mole99/sg13g2_leo_ip__ota5t/docs/sg13g2_leo_ip__ota5t_pex.md

# CACE Summary for sg13g2_leo_ip__ota5t

**netlist source**: pex

| Parameter | Tool | Result | Min Limit  |  Min Value | Typ Target |  Typ Value | Max Limit  |  Max Value |  Status  |
| :--- | :--- | :--- | ---: | ---: | ---: | ---: | ---: | ---: | :---: |
| DC gain | ngspice | a0 | 10 V/V | 19.362 V/V | any | 30.532 V/V | any | 44.194 V/V | Pass ✅ |
| Unity Gain Frequency | ngspice | ugf | 1e6 Hz | 15563000.000 Hz | any | 21388300.000 Hz | any | 27341000.000 Hz | Pass ✅ |
| Phase Margin | ngspice | pm | 60 ° | 85.090 ° | any | 86.393 ° | any | 88.294 ° | Pass ✅ |
| DC gain MC | ngspice | a0 | 10 V/V | 13.176 V/V | any | 21.056 V/V | any | 28.911 V/V | Pass ✅ |
| Area | magic_area | area | | | | | 600 µm² | 76.850 µm² | Pass ✅ |
| Width | magic_area | width | | | | | any | 9.685 µm | Pass ✅ |
| Height | magic_area | height | | | | | any | 7.935 µm | Pass ✅ |
| Magic DRC | magic_drc | drc_errors | | | | | 0 | 0 | Pass ✅ |
| Netgen LVS | netgen_lvs | lvs_errors | | | | | 0 | 0 | Pass ✅ |
| KLayout DRC maximal  | klayout_drc | drc_errors | | | | | 0 | 0 | Pass ✅ |
| Antenna Checks | magic_antenna_check  | antenna_violations | | | | | 0 | 0 | Pass ✅ |

## Plots

## gain_vs_temp

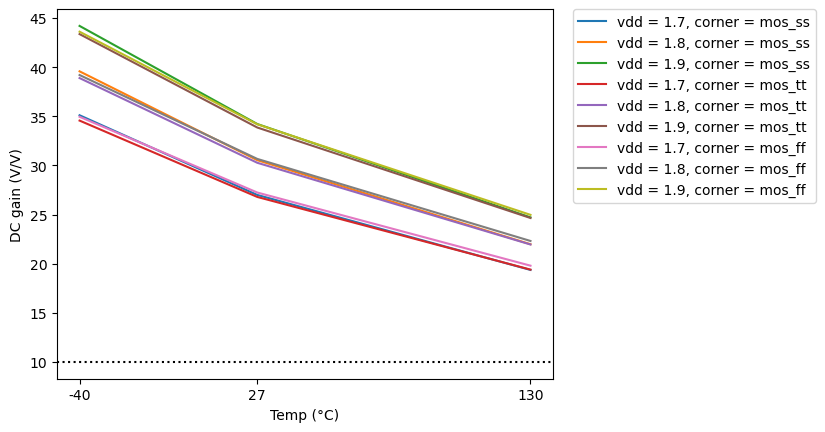
[picture p10: docs/sg13g2_leo_ip__ota5t/pex/gain_vs_temp.png]
gain_vs_temp


## ugf_vs_corner

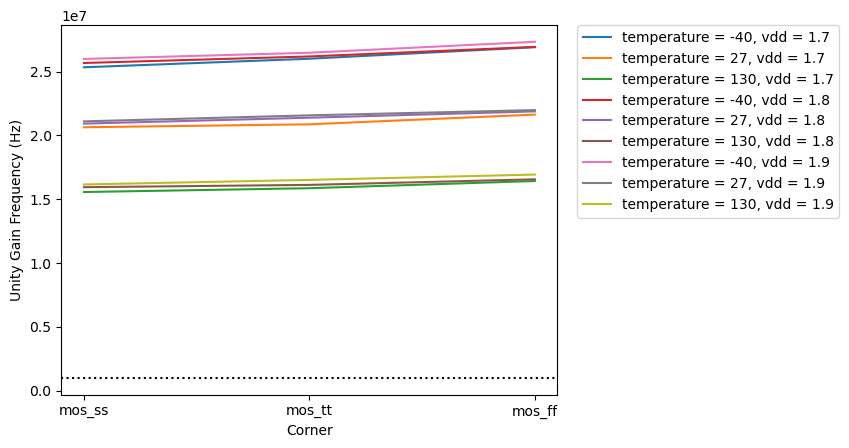
[picture p11: docs/sg13g2_leo_ip__ota5t/pex/ugf_vs_corner.png]
ugf_vs_corner


## pm_vs_vdd

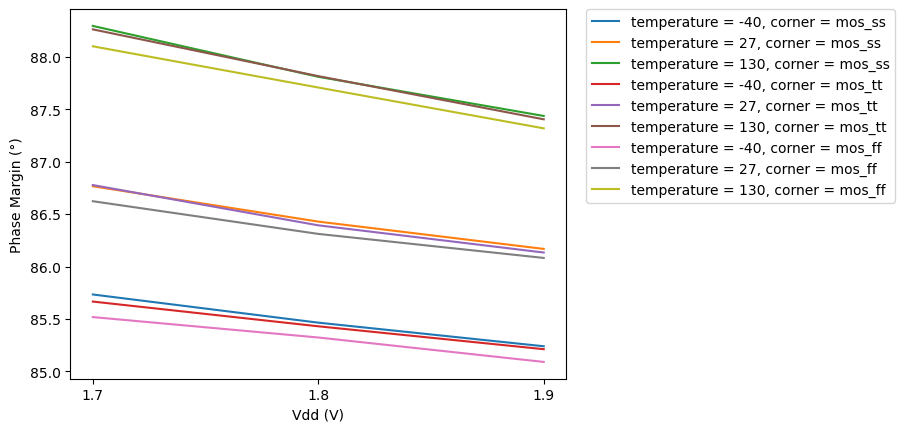
[picture p12: docs/sg13g2_leo_ip__ota5t/pex/pm_vs_vdd.png]
pm_vs_vdd


## gain_mc

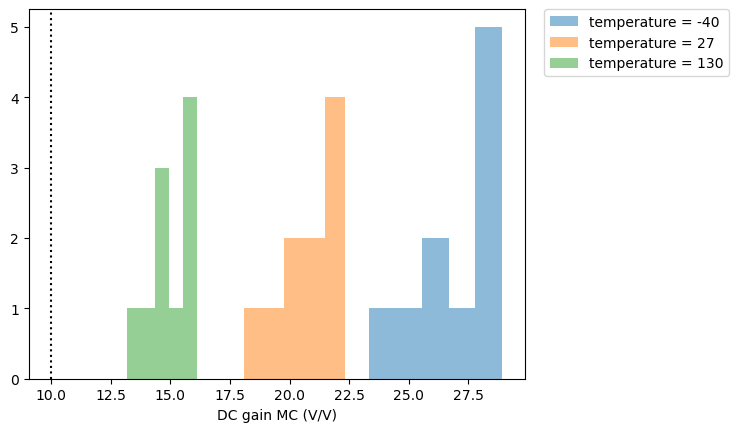
[picture p13: docs/sg13g2_leo_ip__ota5t/pex/gain_mc.png]
gain_mc


## transient

transient
