mole99/sg13g2_leo_ip__ota5t/cace/sg13g2_leo_ip__ota5t.yaml

#--------------------------------------------------------------
# CACE circuit characterization file
#--------------------------------------------------------------

name:           sg13g2_leo_ip__ota5t
description:    A simple 5-transistor OTA
PDK:            ihp-sg13g2

cace_format:    5.2

authorship:
  designer:         Leo Moser
  creation_date:    June 27, 2025
  license:          Apache 2.0

paths:
  root:             ..
  schematic:        xschem
  layout:           gds
  netlist:          netlist
  documentation:    docs

pins:
  VDD:
    description: Positive analog power supply
    type: power
    direction: inout
    Vmin: 1.4
    Vmax: 1.6
  VSS:
    description: Analog ground
    type: ground
    direction: inout
  Ib:
    description: Bias current input
    type: signal
    direction: input
  Vp:
    description: Voltage positive input
    type: signal
    direction: input
  Vn:
    description: Voltage negative input
    type: signal
    direction: input
  Vout:
    description: Voltage output
    type: signal
    direction: output

default_conditions:
  vdd:
    description: Analog power supply voltage
    display: Vdd
    unit: V
    typical: 1.5
  vcm:
    description: Input common mode voltage
    display: Vcm
    unit: V
    typical: 0.75
  ib:
    description: Bias current
    display: Ib
    unit: uA
    typical: 10
  cl:
    description: Output load capacitance
    display: CLoad
    unit: pF
    maximum: 1
  corner:
    description: Process corner
    display: Corner
    typical: mos_tt
  temperature:
    description: Ambient temperature
    display: Temp
    unit: °C
    typical: 27

parameters:
  dc_params:
    display: DC Params
    spec:
      a0:
        display: DC gain
        description: The DC gain of the OTA
        unit: V/V
        minimum:
          value: 10
        typical:
          value: any
        maximum:
          value: any
      ugf:
        display: Unity Gain Frequency
        description: The unity gain frequency of the OTA
        unit: Hz
        minimum:
          value: 1e6
        typical:
          value: any
        maximum:
          value: any
      pm:
        display: Phase Margin
        description: The phase margin of the OTA
        unit: °
        minimum:
          value: 60
        typical:
          value: any
        maximum:
          value: any
    tool:
      ngspice:
        template: ac.sch
        format: ascii
        suffix: .data
        variables: [a0, ugf, pm]
    plot:
      gain_vs_temp:
        type: xyplot
        xaxis: temperature
        yaxis: a0
        limits: auto
      ugf_vs_corner:
        type: xyplot
        xaxis: corner
        yaxis: ugf
        limits: true
      pm_vs_vdd:
        type: xyplot
        xaxis: vdd
        yaxis: pm
        limits: false
    conditions:
      corner:
        minimum: mos_ss
        typical: mos_tt
        maximum: mos_ff
      vdd:
        minimum: 1.7
        typical: 1.8
        maximum: 1.9
      temperature:
        minimum: -40
        typical: 27
        maximum: 130

  gain_mc:
    description: DC gain Monte Carlo
    display: DC gain MC
    unit: V/V
    spec:
      a0:
        minimum:
          value: 10
        typical:
          value: any
        maximum:
          value: any
    tool:
      ngspice:
        template: ac.sch
        # Merge runs with the same conditions
        # but different iterations
        # This is used for plotting
        collate: iterations
        format: ascii
        suffix: .data
        variables: [a0, null, null]
    plot:
      gain_mc:
        type: histogram
        xaxis: a0
        limits: auto
    conditions:
      iterations:
        description: Iterations to run
        display: Iterations
        minimum: 1
        maximum: 10
        step: linear
        stepsize: 1
      corner:
        typical: mos_tt_stat
      temperature:
        minimum: -40
        typical: 27
        maximum: 130

  transient_response:
    description: Large signal transient response
    display: Large signal transient response
    status: skip
    unit: mV
    tool:
      ngspice:
        template: transient.sch
        format: ascii
        suffix: .data
        variables: [time, Vout, Vinp]
        jobs: 4
    plot:
      transient:
        suffix: .svg
        xaxis: time
        yaxis: [Vout, Vinp]
    variables:
      time:
        display: Time
        unit: ms
      Vinp:
        display: Vinp
        unit: V
      Vout:
        display: Vout
        unit: V
    conditions:
      Tmax:
        display: Simulation time
        unit: ns
        typical: 500
      temperature:
        minimum: -40
        typical: 27
        maximum: 130
      corner:
        minimum: mos_ss
        typical: mos_tt
        maximum: mos_ff

  magic_area:
    spec:
      area:
        display: Area
        description: Total circuit layout area
        unit: µm²
        maximum:
          value: 600
      width:
        display: Width
        description: Total circuit layout width
        unit: µm
        maximum:
          value: any
      height:
        display: Height
        description: Total circuit layout height
        unit: µm
        maximum:
          value: any
    tool:
      magic_area

  magic_drc:
    description: Magic DRC
    display: Magic DRC
    spec:
      drc_errors:
        maximum:
          value: 0
    tool:
      magic_drc:
        gds_flatten: true

  netgen_lvs:
    description: Netgen LVS
    display: Netgen LVS
    spec:
      lvs_errors:
        maximum:
          value: 0
    tool:
      netgen_lvs:
        script: run_project_lvs.tcl

  klayout_drc_maximal:
    description: KLayout DRC maximal
    display: KLayout DRC maximal
    spec:
      drc_errors:
        maximum:
          value: 0
    tool:
        klayout_drc:
            jobs: max
            args: ['-rd', 'densityRules=false']

#  klayout_lvs:
#    description: KLayout LVS
#    display: KLayout LVS
#    spec:
#      lvs_errors:
#        maximum:
#          value: 0
#    tool:
#        klayout_lvs:
#            jobs: max
#            args: [
#              '-rd', 'spice_net_names=true',
#              '-rd', 'spice_comments=true',
#              '-rd', 'scale=true',
#              '-rd', 'verbose=true',
#              '-rd', 'schematic_simplify=true',
#              '-rd', 'net_only=true',
#              '-rd', 'top_lvl_pins=true',
#              '-rd', 'combine=true',
#              '-rd', 'purge=true',
#              '-rd', 'purge_nets=true',
#              '-rd', 'lvs_sub=VSS',
#              '-rd', 'convert_subckts=true',
#            ]

  magic_antenna_check:
    description: Run antenna violation check using magic
    display: Antenna Checks
    spec:
      antenna_violations:
        maximum:
          value: 0
    tool:
        magic_antenna_check
